zekekoch/QueenFX/hardware/queencontroller2022.pdf

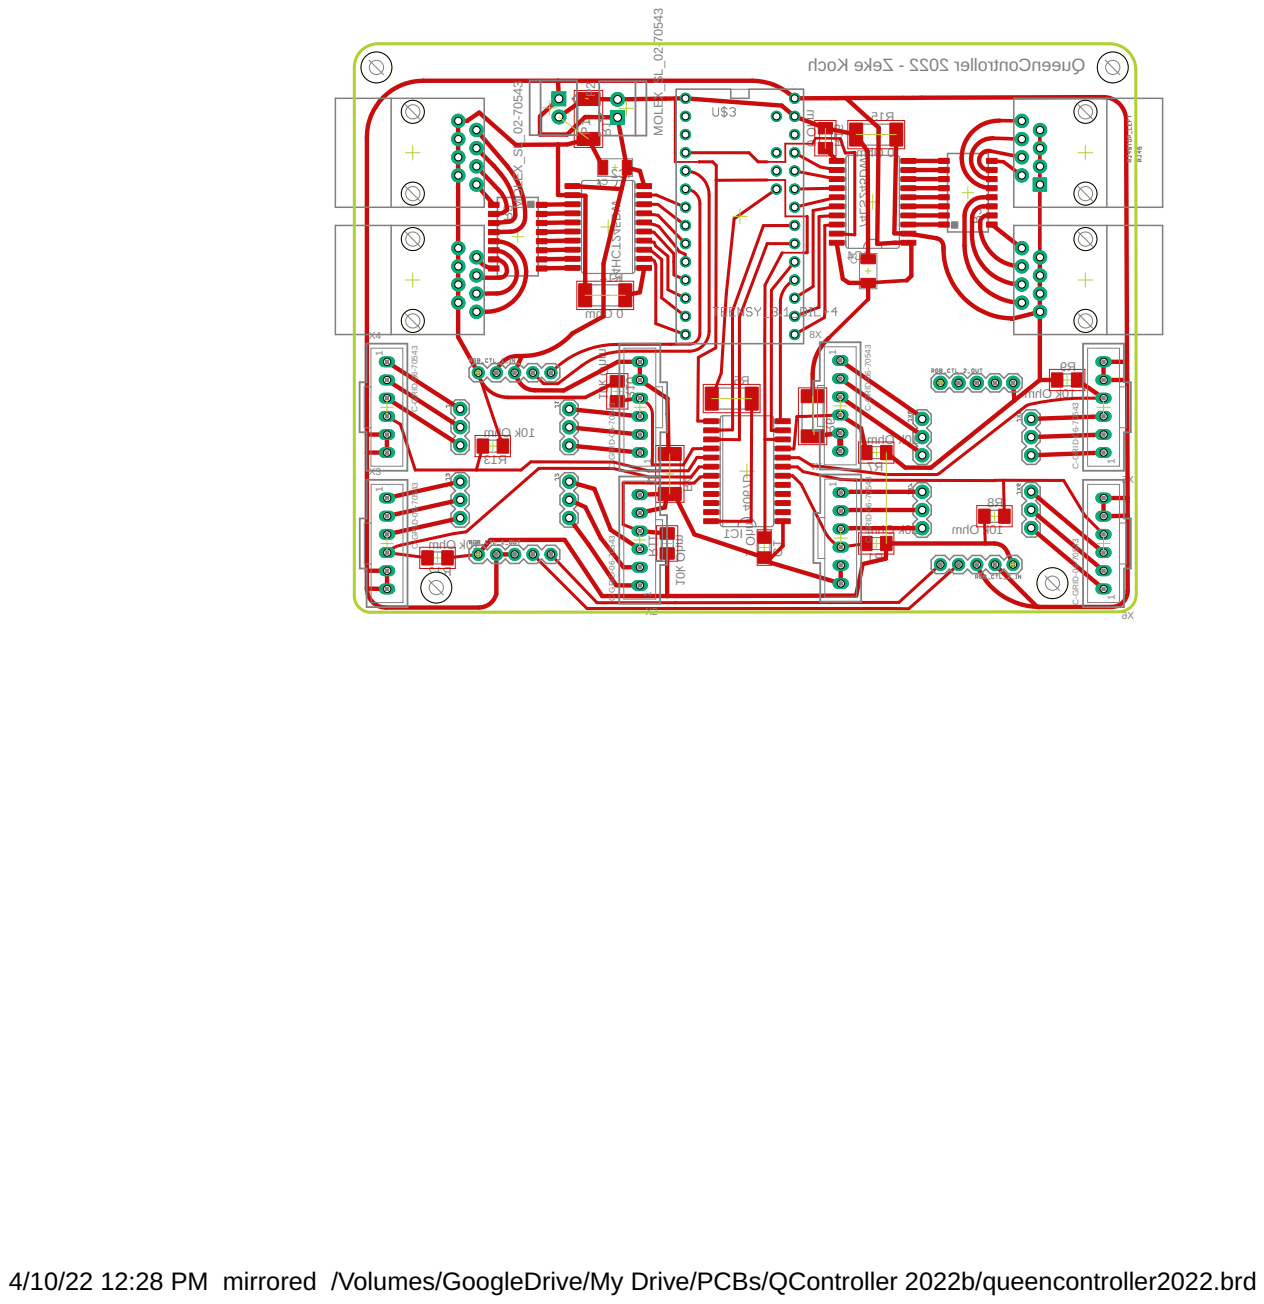
[picture p1: page 1]

R16 hcoK ekeZ- 2202r ell ort no Cneeu Q

4/10/22 12:28 PM mirrored /Volumes/GoogleDrive/My Drive/PCBs/QController 2022b/queencontroller2022.brd
