zekekoch/QueenFX/hardware/queencontroller2022.brd

## EAGLE design hardware/queencontroller2022.brd (2026-11-02)

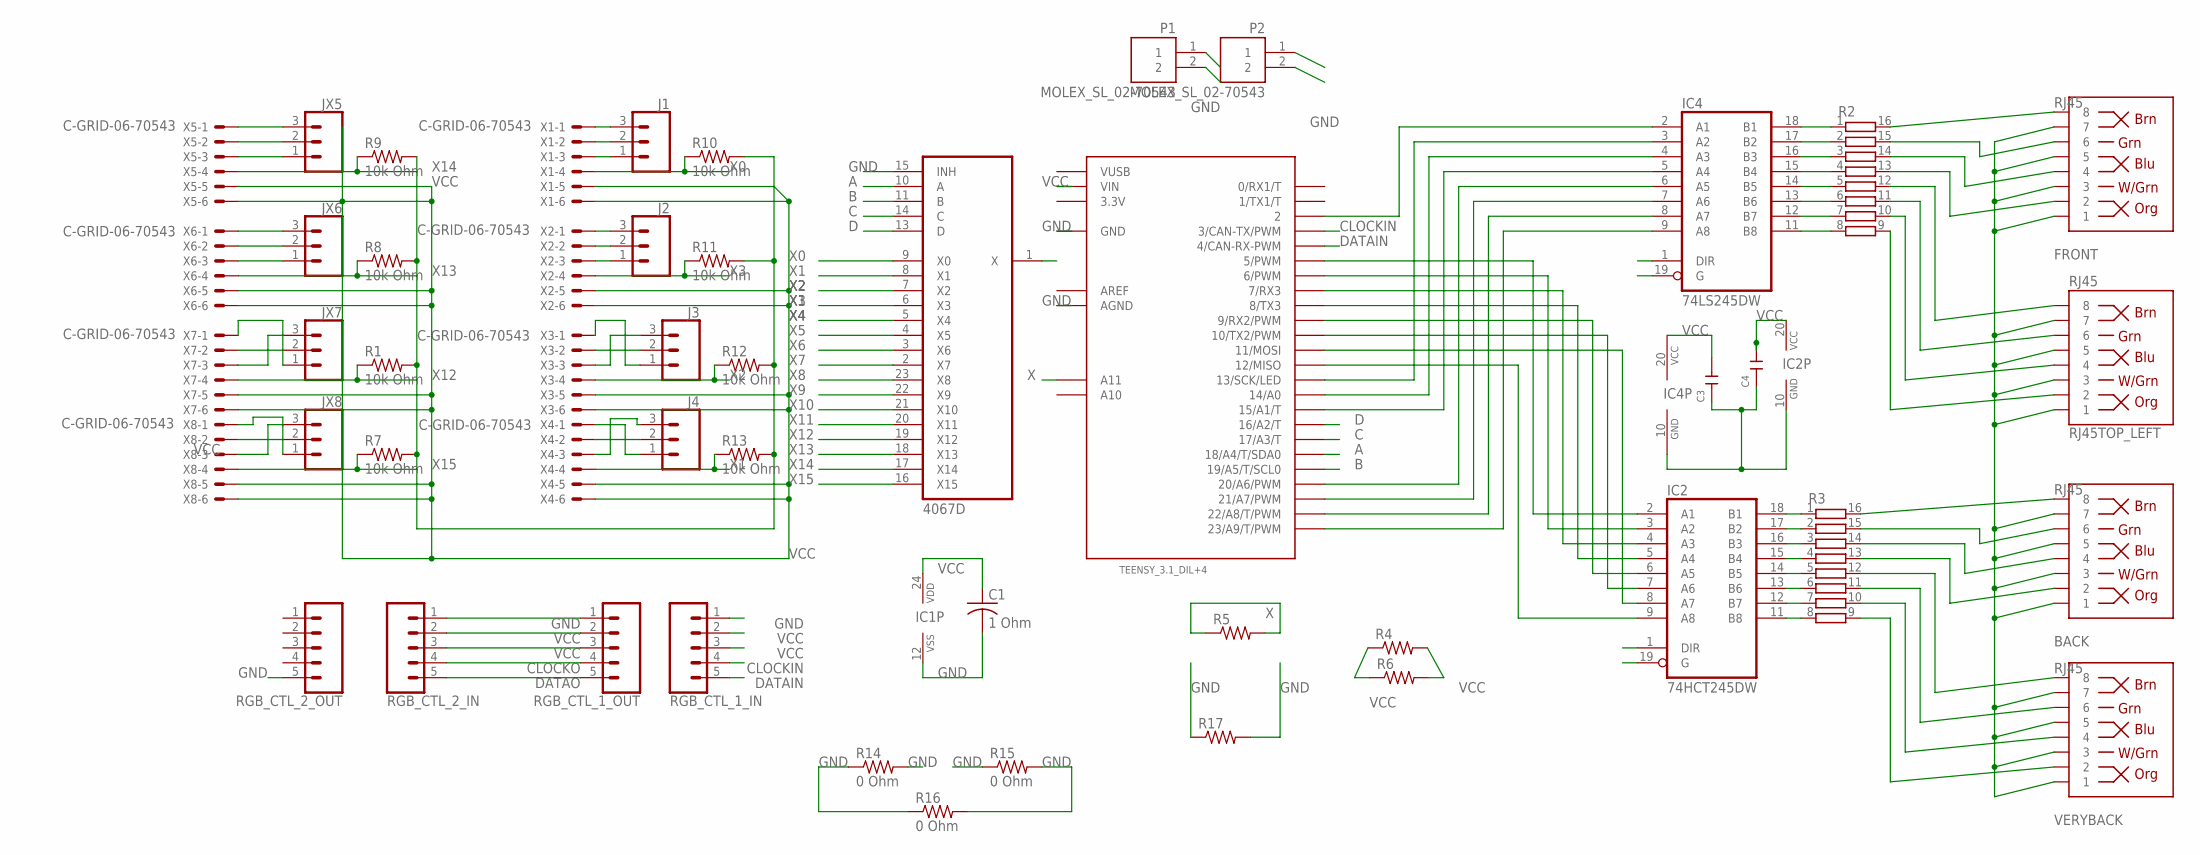
[picture p2: schematic queencontroller2022.sch, sheet 1]

Parts:
BACK: RJ45; RJ45-8
C1: 1 Ohm; C1206
C3, C4: CAP-1206; C1206
FRONT: RJ45; RJ45-8
IC1: 4067D; SO24W
IC2: 74HCT245DW; SO20W
IC4: 74LS245DW; SO20W
J1, J2, J3, J4: CONN_03; 1X03
JX5, JX6, JX7, JX8: CONN_03; 1X03
P1, P2: MOLEX_SL_02-70543; SL_70543_2
R1, R7, R8, R9, R10, R11, R12, R13: 10k Ohm; M1206
R2, R3: 4816P-T01; 4816P
R4, R5, R6, R17: R-US_R2512; R2512
R14, R15: 0 Ohm; R2512
R16: 0 Ohm; M1206
RGB_CTL_1_IN, RGB_CTL_1_OUT, RGB_CTL_2_IN, RGB_CTL_2_OUT: CONN_05; 1X05
RJ45TOP_LEFT: RJ45; RJ45-8
U$3: TEENSY_3.1_DIL+4; TEENSY3-DIL+4
VERYBACK: RJ45; RJ45-8
X1, X2, X3, X4, X5, X6, X7, X8: C-GRID-06-70543; 70543-06

Connections:
3.3V: U$3.3.3V
A: IC1.10 (A), U$3.18/A4 (18/A4/T/SDA0)
AREF: U$3.AREF
B: IC1.11 (B), U$3.19/A5 (19/A5/T/SCL0)
C: IC1.14 (C), U$3.17/A3 (17/A3/T)
CLOCKIN: RGB_CTL_1_IN.4, U$3.3 (3/CAN-TX/PWM)
CLOCKO: RGB_CTL_1_OUT.4, RGB_CTL_2_IN.4
D: IC1.13 (D), U$3.16/A2 (16/A2/T)
DATAIN: RGB_CTL_1_IN.5, U$3.4 (4/CAN-RX-PWM)
DATAO: RGB_CTL_1_OUT.5, RGB_CTL_2_IN.5
GND: BACK.1, BACK.3, BACK.5, BACK.7, C1.2, C3.1, C4.1, FRONT.1, FRONT.3, FRONT.5, FRONT.7, IC1.12 (VSS), IC1.15 (INH), IC2.10 (GND), IC2.19 (G), IC4.10 (GND), IC4.19 (G), P1.2, P2.2, R1.2, R7.2, R8.2, R9.2, R10.2, R11.2, R12.2, R13.2, R14.1, R14.2, R15.1, R15.2, R16.1, R16.2, R17.1, R17.2, RGB_CTL_1_IN.1, RGB_CTL_1_OUT.1, RGB_CTL_2_IN.1, RGB_CTL_2_OUT.5, RJ45TOP_LEFT.1, RJ45TOP_LEFT.3, RJ45TOP_LEFT.5, RJ45TOP_LEFT.7, U$3.AGND, U$3.GND, VERYBACK.1, VERYBACK.3, VERYBACK.5, VERYBACK.7
unnamed: FRONT.8, R2.16
unnamed: FRONT.6, R2.15
unnamed: FRONT.4, R2.14
unnamed: FRONT.2, R2.13
unnamed: R2.10, RJ45TOP_LEFT.4
unnamed: IC2.18 (B1), R3.1
unnamed: R2.12, RJ45TOP_LEFT.8
unnamed: IC4.18 (B1), R2.1
unnamed: BACK.8, R3.16
unnamed: BACK.6, R3.15
unnamed: BACK.4, R3.14
unnamed: BACK.2, R3.13
unnamed: J3.3, X3.3
unnamed: R3.11, VERYBACK.6
unnamed: R3.10, VERYBACK.4
unnamed: R3.9, VERYBACK.2
unnamed: IC4.9 (A8), U$3.23/A9 (23/A9/T/PWM)
unnamed: IC2.9 (A8), U$3.12 (12/MISO)
unnamed: IC2.2 (A1), U$3.5 (5/PWM)
unnamed: IC2.3 (A2), U$3.6 (6/PWM)
unnamed: IC2.4 (A3), U$3.7 (7/RX3)
unnamed: IC2.5 (A4), U$3.8 (8/TX3)
unnamed: IC2.6 (A5), U$3.9 (9/RX2/PWM)
unnamed: IC2.7 (A6), U$3.10 (10/TX2/PWM)
unnamed: IC2.8 (A7), U$3.11 (11/MOSI)
unnamed: IC4.8 (A7), U$3.22/A8 (22/A8/T/PWM)
unnamed: IC4.7 (A6), U$3.21/A7 (21/A7/PWM)
unnamed: IC4.6 (A5), U$3.20/A6 (20/A6/PWM)
unnamed: IC4.5 (A4), U$3.15/A1 (15/A1/T)
unnamed: IC4.4 (A3), U$3.14/A0
unnamed: IC4.3 (A2), U$3.13 (13/SCK/LED)
unnamed: IC4.2 (A1), U$3.2
unnamed: IC4.17 (B2), R2.2
unnamed: IC4.16 (B3), R2.3
unnamed: IC4.15 (B4), R2.4
unnamed: IC4.14 (B5), R2.5
unnamed: IC4.13 (B6), R2.6
unnamed: IC4.12 (B7), R2.7
unnamed: IC4.11 (B8), R2.8
unnamed: R2.9, RJ45TOP_LEFT.2
unnamed: IC2.17 (B2), R3.2
unnamed: IC2.16 (B3), R3.3
unnamed: IC2.15 (B4), R3.4
unnamed: IC2.14 (B5), R3.5
unnamed: IC2.13 (B6), R3.6
unnamed: IC2.12 (B7), R3.7
unnamed: IC2.11 (B8), R3.8
unnamed: J3.1, X3.1
unnamed: JX5.3, X5.1
unnamed: JX5.2, X5.2
unnamed: JX5.1, X5.3
unnamed: J4.1, X4.1
unnamed: JX6.3, X6.1
unnamed: JX6.2, X6.2
unnamed: JX6.1, X6.3
unnamed: JX7.3, X7.3
unnamed: JX7.2, X7.2
unnamed: JX7.1, X7.1
unnamed: J4.3, X4.3
unnamed: JX8.3, X8.3
unnamed: JX8.2, X8.2
unnamed: JX8.1, X8.1
unnamed: R2.11, RJ45TOP_LEFT.6
unnamed: R3.12, VERYBACK.8
unnamed: J4.2, X4.2
unnamed: J3.2, X3.2
unnamed: J2.1, X2.3
unnamed: J2.2, X2.2
unnamed: J2.3, X2.1
unnamed: J1.1, X1.3
unnamed: J1.2, X1.2
unnamed: J1.3, X1.1
VCC: C1.1, C3.2, C4.2, IC1.24 (VDD), IC2.1 (DIR), IC2.20 (VCC), IC4.1 (DIR), IC4.20 (VCC), P1.1, P2.1, R4.1, R4.2, R6.1, R6.2, RGB_CTL_1_IN.2, RGB_CTL_1_IN.3, RGB_CTL_1_OUT.2, RGB_CTL_1_OUT.3, RGB_CTL_2_IN.2, RGB_CTL_2_IN.3, U$3.VIN, X1.5, X1.6, X2.5, X2.6, X3.5, X3.6, X4.5, X4.6, X5.5, X5.6, X6.5, X6.6, X7.5, X7.6, X8.5, X8.6
VUSB: U$3.VUSB
X: IC1.1 (X), R5.1, R5.2, U$3.A11
X0: IC1.9 (X0), R10.1, X1.4
X1: IC1.8 (X1), R13.1, X4.4
X2: IC1.7 (X2), R12.1, X3.4
X3: IC1.6 (X3), R11.1, X2.4
X4: IC1.5 (X4)
X5: IC1.4 (X5)
X6: IC1.3 (X6)
X7: IC1.2 (X7)
X8: IC1.23 (X8)
X9: IC1.22 (X9)
X10: IC1.21 (X10)
X11: IC1.20 (X11)
X12: IC1.19 (X12), R1.1, X7.4
X13: IC1.18 (X13), R8.1, X6.4
X14: IC1.17 (X14), R9.1, X5.4
X15: IC1.16 (X15), R7.1, X8.4

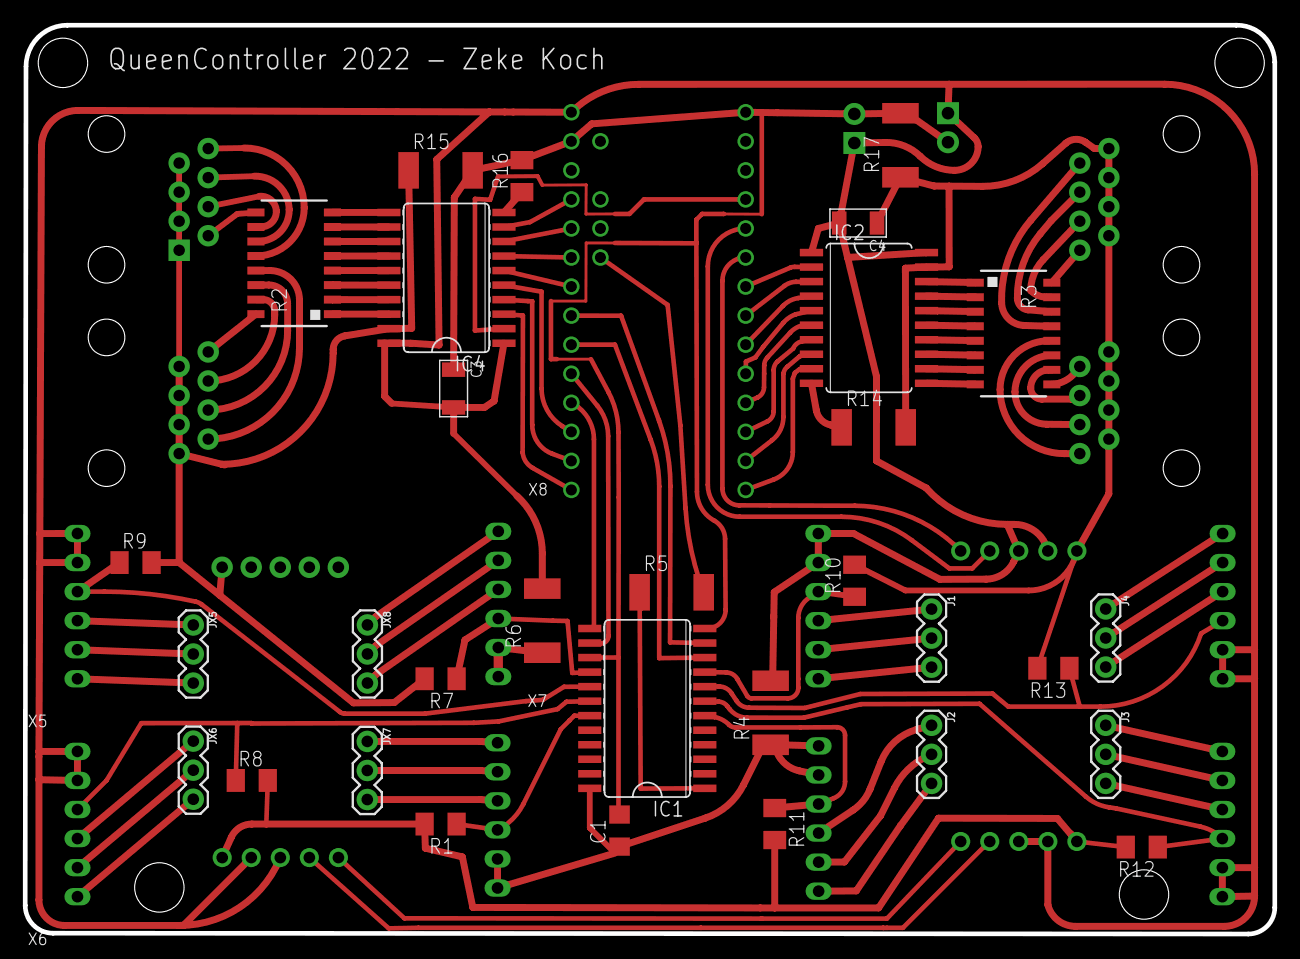
[picture p3: board queencontroller2022.brd from above]

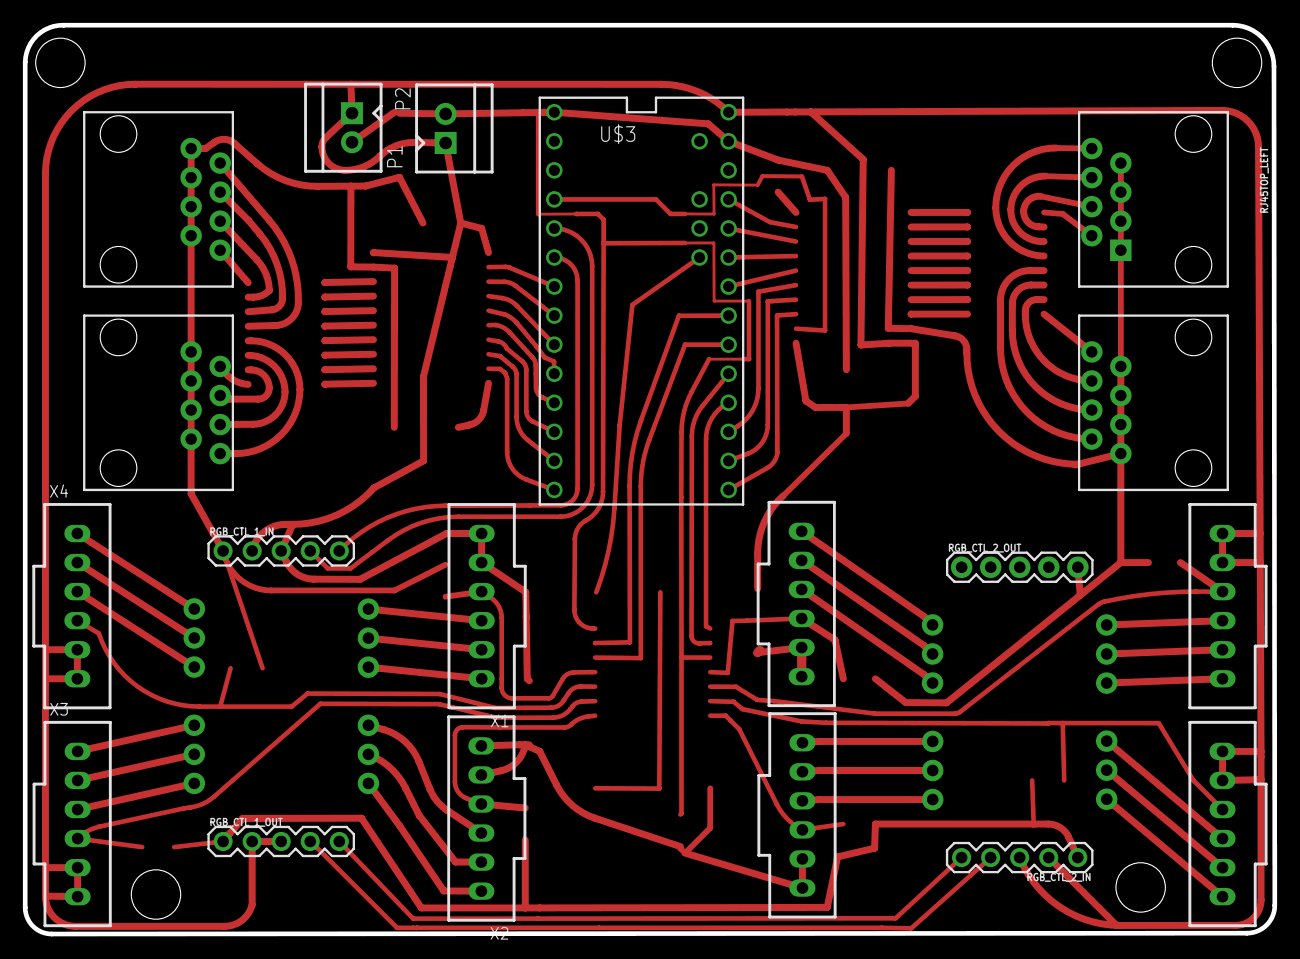
[picture p4: board queencontroller2022.brd from below]

Board: 2 copper layers, 109.2 x 79.5 mm, 50 parts (19 on the bottom side), 91 nets.
