zekekoch/QueenFX/(commit log)

2015-08-04 Burningman Art Car 2015
    [QueenFX.ino]
2015-08-08 smoothing and pallets
    Added some smoothing on the dial and buttons
    Added Palette support
    Pulled some animations that weren’t interesting
    Added beginning of Fire animation
2015-08-22 improved virtual mapping
    The front lights are now mapped more correctly.
    I’ve also added a couple of new animations (from Mark)
    [QueenFX.ino]
2015-09-08 Final BM15 settings
    Control panel was destroyed so I hard coded it to rotating rainbow…
2016-08-22 started doubling lights
    doubled everything (I think) and switched a lot of stuff from bytes to
    ints
    removed the cushions
2016-08-26 interim update for 2016
    cleaned up mapping. my new boards have the strips in a different order
    than fastled so I needed to add another layer of indirection for that.
    I still need to reverse the front ones.
    [QueenFX.ino]
2019-08-14 Switched to use push buttons instead of my more complex dashboard
2019-08-16 added some new animations
    I added some new animations and switched the buttons from pulldown to pullup
2019-08-23 tweaking which button does which task
2019-08-23 added more animations to the buttons
2019-08-24 getting close
    fixed the tailLights (mapping issue)
    got rid of the dashbaord lights since I'm not using that
    mirrored rotating rainbox
    [QueenFX.ino]
2019-08-24 tube length tweaking
    i'm creeped out that my tubes are different lengths this year... that's not making sense.
2019-09-05 Update QueenFX.ino
    A few final tweaks for tube lengths
2022-04-15 Update QueenFX.ino
    Starting to make changes for 2022. I have a flickering issue likely caused by the libraries loaded into Buttons.h, but I'm not sure yet.
    [QueenFX.ino]
2022-04-16 Update QueenFX.ino
    wow, so after checking all of my electrical, and systematically getting back to the very root of my code I found out that the flickering issue came from a bug in the initializer for FastLED. I now set up each port (PORTD and PORTC) independently. Never would have guessed that. The crazy thing is that it must be a subtle timing thing...
    [QueenFX.ino]
2022-04-16 Update QueenFX.ino
    fixed up the mapping (put the ground effect lights at the back). All the strips are lit up now. I still need to fix the front three lights (they're hard coded and I'm having a little trouble thinking through all of the indirection so I'll tackle that later).
    [QueenFX.ino]
2022-05-01 Update QueenFX.ino
    cleaning up the mapping. a couple of gaffs, first I was initializing my mapping arrays incorrectly and I was double mapping the tail lights. Not sure why I was doing that. I removed the second mapping and cleaned up showleds.
2022-05-01 Update QueenFX.ino
    So much progress, but brain dead for the day. Renamed tubeLengths to tubeLength because I kept getting it wrong. Wrote a simple program to test colors, fixed up ShowLeds (mostly fixing off by one errors and simplifying a bit), DebugColors and fixed mirror and fillsolid to respect the tube lengths.
    [QueenFX.ino]
2022-05-02 Update QueenFX.ino
    Wow, so I realized that I now have 16 sections of light strips (14 tubes, the tail lights and ground effect lights). I had increased numStrips, but didn't increase the number of entries in tubeLength. That didn't use to matter (because I used to ignore the length of the strips in showLeds, but after I fixed up showLeds my taillights wouldn't display because the taillights had moved outside of the number of entries I defined in tubelength. It sure would have been nice to get an error that I was only partially initializing my array.
    I also added the ground effect lights (which was easy one I figured out the tail light problem...).
    [QueenFX.ino]
2025-06-02 Fix typo in setup comment
    [QueenFX.ino]
2026-11-02 Add missing Mux.h and remove stray conflict marker
    Buttons.h includes Mux.h and uses CMux, but the file was never
    pushed. Also delete a leftover "=======" merge marker in QueenFX.ino.
2026-11-02 Add README with Teensyduino and library setup
2026-11-02 Add QueenController 2022b schematic and board layout
    Eagle .sch/.brd plus a PDF print of the board, copied from the
    PCBs/QController 2022b folder in Google Drive.
2026-11-02 Button 7 toggles debug colors instead of police lights
    debugColors() was running on every frame; now it only runs while
    button 7 is latched on.
